HaoboChen1887/FaceTrackingDrone/poster/ground station.jpeg

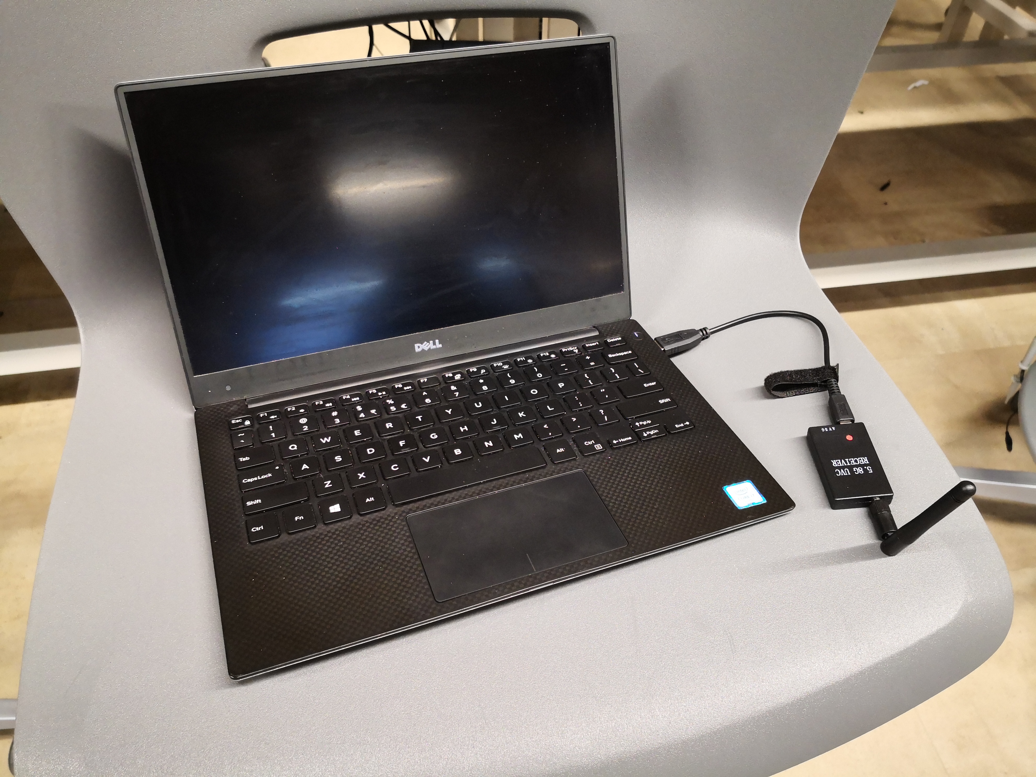
poster/ground station.jpeg
