HaoboChen1887/FaceTrackingDrone/poster/drone.jpeg

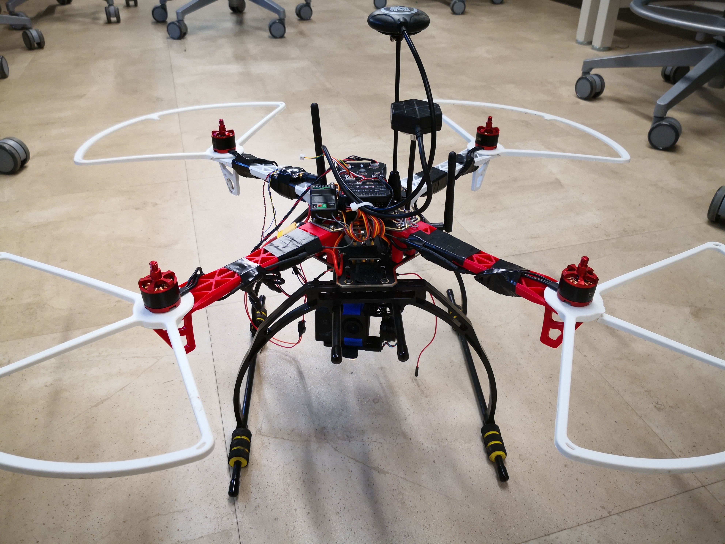
poster/drone.jpeg
