HaoboChen1887/FaceTrackingDrone/poster/requirement.png

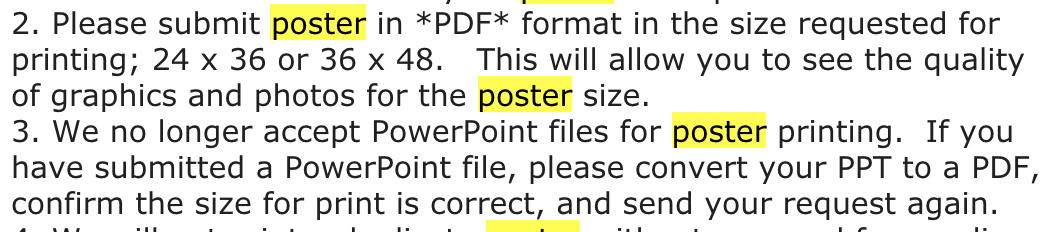
poster/requirement.png
