HaoboChen1887/FaceTrackingDrone/Untitled Diagram.png

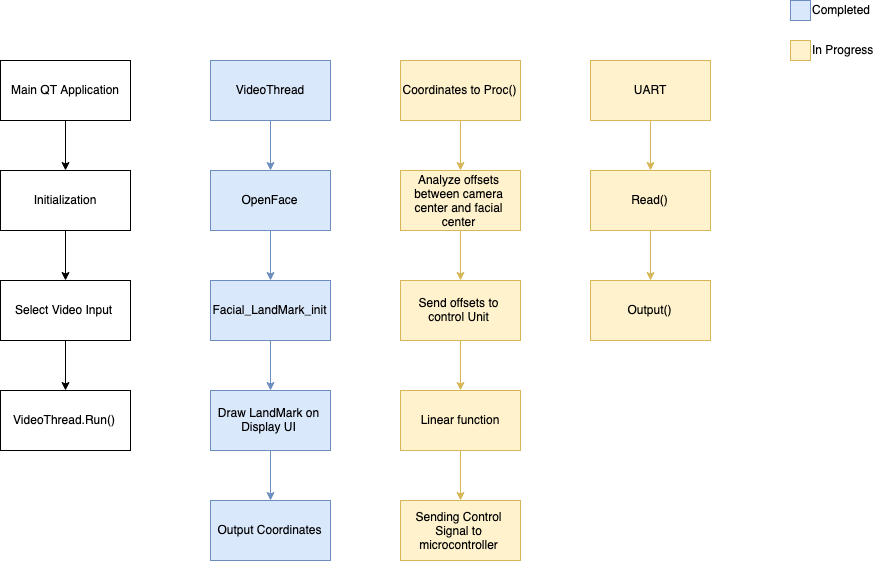
Untitled Diagram.png
