HaoboChen1887/FaceTrackingDrone/Documents(Assignments)/5_BillOfMaterials.xlsx

ECE477 Bill of Materials v1.0
Year: | 2019 |  | Semester: | Spring | Project Name: | Face Tracking Drone
Author: | Xufei Gao | gao288@purdue.edu
 | Xingchen Wang | wang2930@purdue.edu
 | Yi Qiao | qiao22@purdue.edu
 | Haobo Chen | chen1887@purdue.edu
Created: | Jan 29,2019
Last Modified: | Jan 29,2019
Project_Component |  |  |  |  |  |  |  | Qty:
Description | ID | Qty | Value | Package | Manufacturer | Mfg. Part # | Supplier | Supplier Part #
Microcontroller
FS-i6X 10CH 2.4GHz AFHDS RC Transmitter w/ FS-iA6B Receiver |  | 1 |  | standalone | Flysky | FS-i6X | Amazon | N/A
DJI Genuine Plastic 9450 Self-tightening Propellers | 9450 | 4 |  | standalone | DJI | - | Amazon | N/A
FPV 5.8GHz Receiver, 150CH UVC Video Downlink OTG Receiver |  | 1 |  | standalone | Otryad | - | Amazon | N/A
Wolfwhoop T86 0/25mW/200mW/600mW Switchable FPV Transmitter |  | 1 |  | standalone | Wolfwhoop | T86 | Amazon | N/A
Goliton 5.8g Transmitter FPV A/v Video Real-time Output Cable Cord |  | 1 |  | standalone | Goliton |  | Amazon | N/A
HRB 11.1V 5000mAh 3S 50C-100C LiPo Battery |  | 2 |  | standalone | HRB |  | Amazon | N/A
YoungRC F450 Drone Frame Kit 4-Axis Airframe 450mm Quadcopter Frame Kit with Landing Skid Gear |  | 1 |  | standalone |  | F450 | Amazon | N/A
Radiolink Pixhawk PX4 32 Bit ARM Flight Controller + NEO-M8N GPS + Pixhawk Power Module |  | 1 |  | bundle | Radiolink | PX4 | Amazon | N/A
LHI 4x 2212 920KV Brushless Motor (CW / CCW) + 4x SIMONK 30A ESC |  | 1 |  | bundle | LHI |  | Amazon | N/A
NRF24L01+PA+LNA Wireless Transceiver RF Transceiver Module 2.4G 1100m with Antenna |  | 2 |  | pin | Makerfocus | nrf24l01+ | Amazon | N/A
Capacitor (0.1uF) |  | 3 | 0.1uF | 1206 | Vishay | VJ1206V106ZXQTW1BC | Mouser | 77-VJ1206V106ZXQTBC
