HaoboChen1887/FaceTrackingDrone/Packaging/face_tracking_drone_onflight v1.step

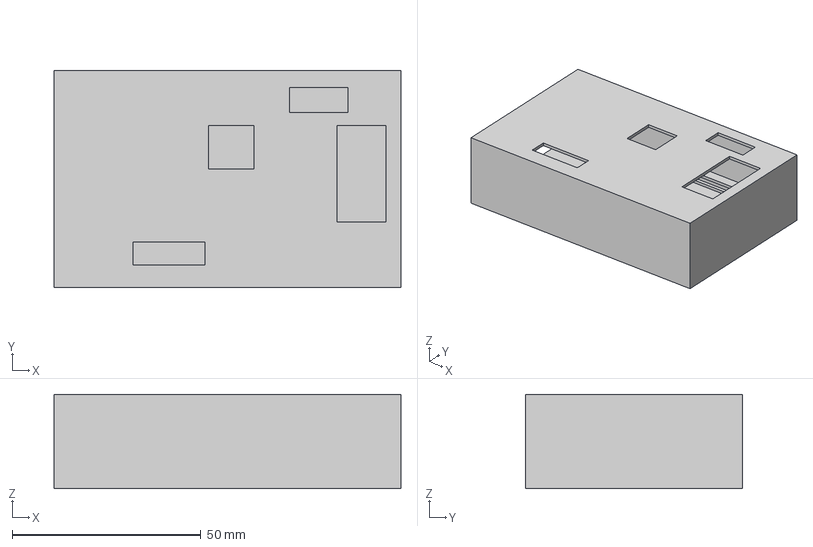
[picture p46: CAD file, 2020-08-21]
Packaging/face_tracking_drone_onflight v1.step
92.0 x 57.5 x 25.0 mm
