HaoboChen1887/FaceTrackingDrone/Packaging/face_tracking_drone_onflight.stl

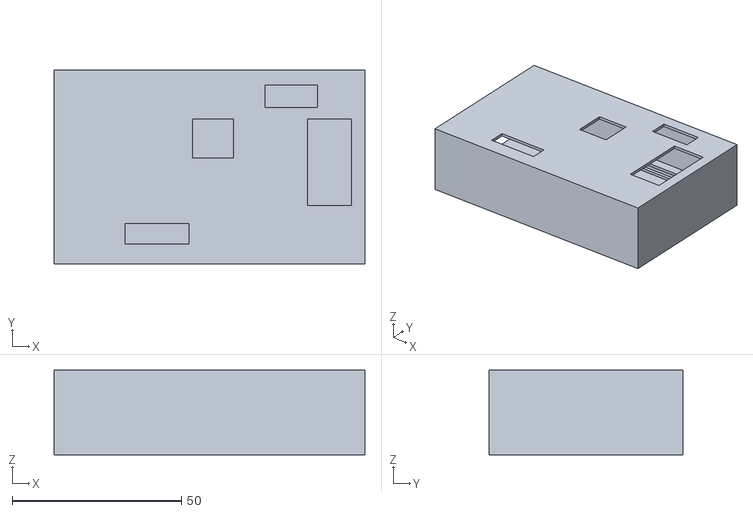
[picture p47: CAD file, 2020-08-21]
Packaging/face_tracking_drone_onflight.stl
92.0 x 57.5 x 25.0
