HaoboChen1887/FaceTrackingDrone/PCB/face_tracking_drone_ground.brd

## EAGLE design PCB/face_tracking_drone_ground.brd (2020-08-21)

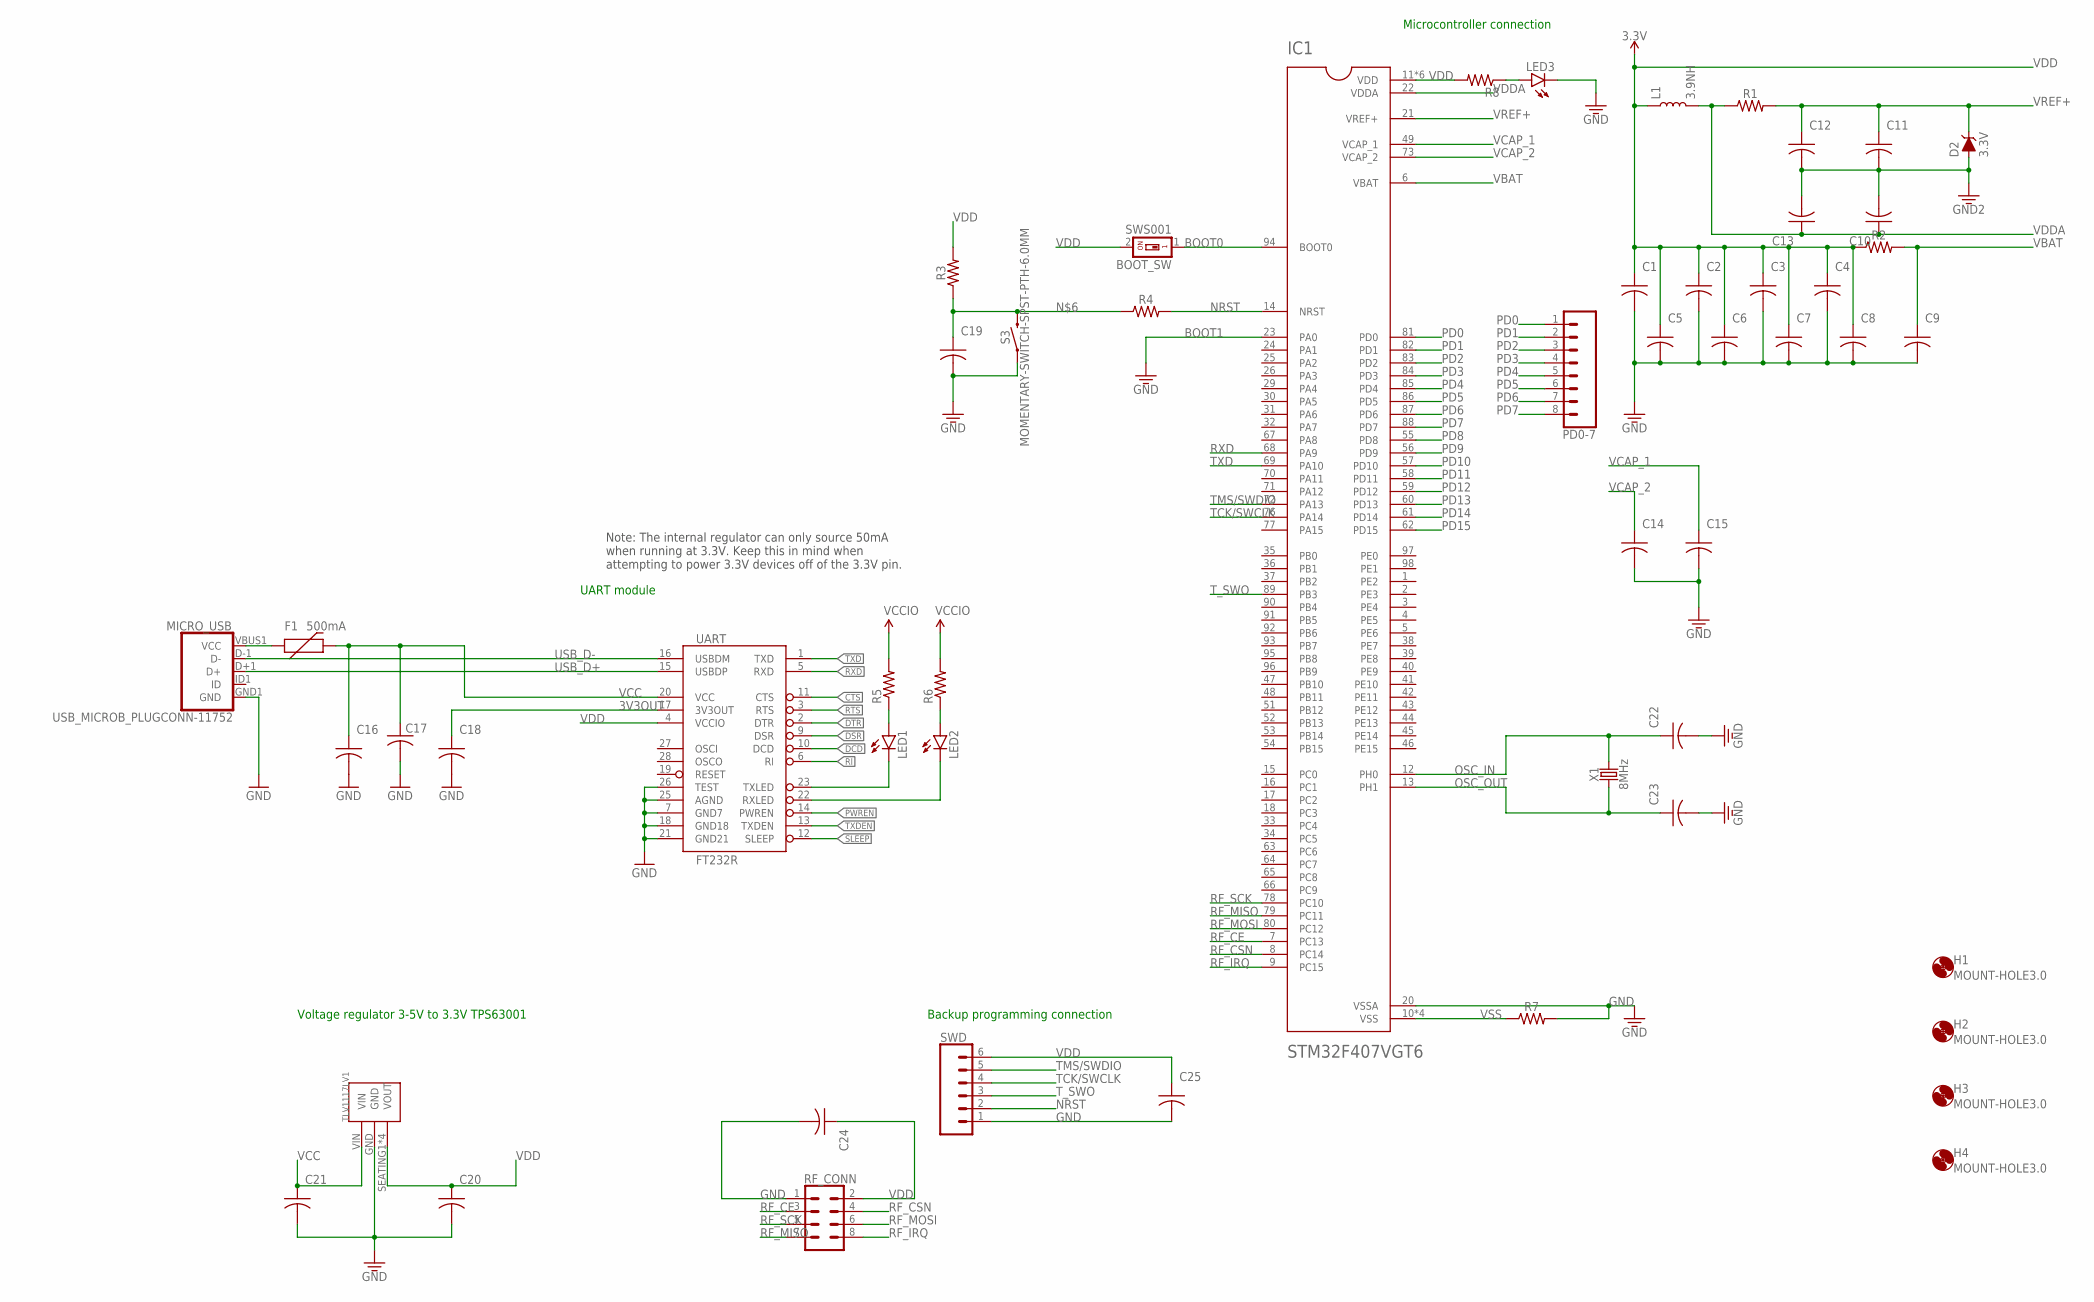
[picture p48: schematic face_tracking_drone_ground.sch]

Parts:
BOOT_SW: SWS001; SMS-001
C1, C2, C3, C4, C5, C6, C7, C8, C9, C10, C11, C16, C18, C20, C21, C24, C25: 0.1uF; C0805
C12, C13: 1uF; C0805
C14, C15, C19: 2.2uF; C0805
C17: 10uF; C0805
C22, C23: 20pF; C0805
D2: 3.3V; SOD-323
F1: 500mA; PTC-1206
H1, H2, H3, H4: MOUNT-HOLE3.0; 3,0
IC1: STM32F407VGT6; QFP50P1600X1600X160-100N
L1: 3.9NH; 0402
LED1: Red; SML0805
LED2, LED3: Green; SML0805
MICRO_USB: USB_MICROB_PLUGCONN-11752; USB-B-MICRO-SMD_V03
PD0-7: CONN_08"; 1X08
R1, R2, R3, R4, R5, R6, R8: M0805
R7: 0805
RF_CONN: CONN_04X2; 2X4
S3: MOMENTARY-SWITCH-SPST-PTH-6.0MM; TACTILE_SWITCH_PTH_6.0MM
SWD: CONN_06SILK_FEMALE_PTH; 1X06
TLV1117LV1: TLV1117LV33DCYR
UART: FT232R; SSOP28DB
X1: 8MHz; HC49U

Connections:
3V3OUT: C18.1, UART.17 (3V3OUT)
BOOT0: BOOT_SW.1, IC1.94 (BOOT0)
BOOT1: IC1.23 (PA0)
CTS: UART.11 (CTS)
DCD: UART.10 (DCD)
DSR: UART.9 (DSR)
DTR: UART.2 (DTR)
GND: C1.2, C2.2, C3.2, C4.2, C5.2, C6.2, C7.2, C8.2, C9.2, C10.2, C11.2, C12.2, C13.2, C14.2, C15.2, C16.2, C17.2, C18.2, C19.2, C20.2, C21.2, C22.2, C23.2, C24.2, C25.2, D2.A, IC1.20 (VSSA), LED3.C, MICRO_USB.GND1 (GND), R7.2, RF_CONN.1, S3.1, SWD.1, TLV1117LV1.GND, UART.7 (GND7), UART.18 (GND18), UART.21 (GND21), UART.25 (AGND), UART.26 (TEST)
unnamed: LED1.A, R5.1
unnamed: LED3.A, R8.1
unnamed: LED2.A, R6.1
unnamed: F1.1, MICRO_USB.VBUS1 (VCC)
unnamed: C19.1, R3.1, R4.1, S3.3 (2)
NRST: IC1.14 (NRST), R4.2, SWD.2
OSC_IN: C22.1, IC1.12 (PH0), X1.2
OSC_OUT: C23.1, IC1.13 (PH1), X1.1
PD0: IC1.81 (PD0), PD0-7.1
PD1: IC1.82 (PD1), PD0-7.2
PD2: IC1.83 (PD2), PD0-7.3
PD3: IC1.84 (PD3), PD0-7.4
PD4: IC1.85 (PD4), PD0-7.5
PD5: IC1.86 (PD5), PD0-7.6
PD6: IC1.87 (PD6), PD0-7.7
PD7: IC1.88 (PD7), PD0-7.8
PD8: IC1.55 (PD8)
PD9: IC1.56 (PD9)
PD10: IC1.57 (PD10)
PD11: IC1.58 (PD11)
PD12: IC1.59 (PD12)
PD13: IC1.60 (PD13)
PD14: IC1.61 (PD14)
PD15: IC1.62 (PD15)
PWREN: UART.14 (PWREN)
RF_CE: IC1.7 (PC13), RF_CONN.3
RF_CSN: IC1.8 (PC14), RF_CONN.4
RF_IRQ: IC1.9 (PC15), RF_CONN.8
RF_MISO: IC1.79 (PC11), RF_CONN.7
RF_MOSI: IC1.80 (PC12), RF_CONN.6
RF_SCK: IC1.78 (PC10), RF_CONN.5
RI: UART.6 (RI)
RTS: UART.3 (RTS)
RXD: IC1.68 (PA9), UART.5 (RXD)
RXLED: LED2.C, UART.22 (RXLED)
SLEEP: UART.12 (SLEEP)
TCK/SWCLK: IC1.76 (PA14), SWD.4
TMS/SWDIO: IC1.72 (PA13), SWD.5
TXD: IC1.69 (PA10), UART.1 (TXD)
TXDEN: UART.13 (TXDEN)
TXLED: LED1.C, UART.23 (TXLED)
T_SWO: IC1.89 (PB3), SWD.3
USB_D+: MICRO_USB.D+1 (D+), UART.15 (USBDP)
USB_D-: MICRO_USB.D-1 (D-), UART.16 (USBDM)
VBAT: C9.1, IC1.6 (VBAT), R2.2
VCAP_1: C15.1, IC1.49 (VCAP_1)
VCAP_2: C14.1, IC1.73 (VCAP_2)
VCC: C16.1, C17.1, C21.1, F1.2, TLV1117LV1.VIN, UART.20 (VCC)
VCCIO: R5.2, R6.2
VDD: BOOT_SW.2, C1.1, C2.1, C3.1, C4.1, C5.1, C6.1, C7.1, C8.1, C20.1, C24.1, C25.1, IC1.11 (VDD), IC1.19 (VDD), IC1.28 (VDD), IC1.50 (VDD), IC1.75 (VDD), IC1.100 (VDD), L1.1, R2.1, R3.2, R8.2, RF_CONN.2, SWD.6, TLV1117LV1.SEATING1 (VOUT), TLV1117LV1.SEATING2 (VOUT), TLV1117LV1.SEATING3 (VOUT), TLV1117LV1.VOUT, UART.4 (VCCIO)
VDDA: C10.1, C13.1, IC1.22 (VDDA), L1.2, R1.1
VREF+: C11.1, C12.1, D2.C, IC1.21 (VREF+), R1.2
VSS: IC1.10 (VSS), IC1.27 (VSS), IC1.74 (VSS), IC1.99 (VSS), R7.1

Notes on the sheet:
Microcontroller connection
Voltage regulator 3-5V to 3.3V TPS63001
Note: The internal regulator can only source 50mA when running at 3.3V. Keep this in mind when attempting to power 3.3V devices off of the 3.3V pin.
UART module
Backup programming connection

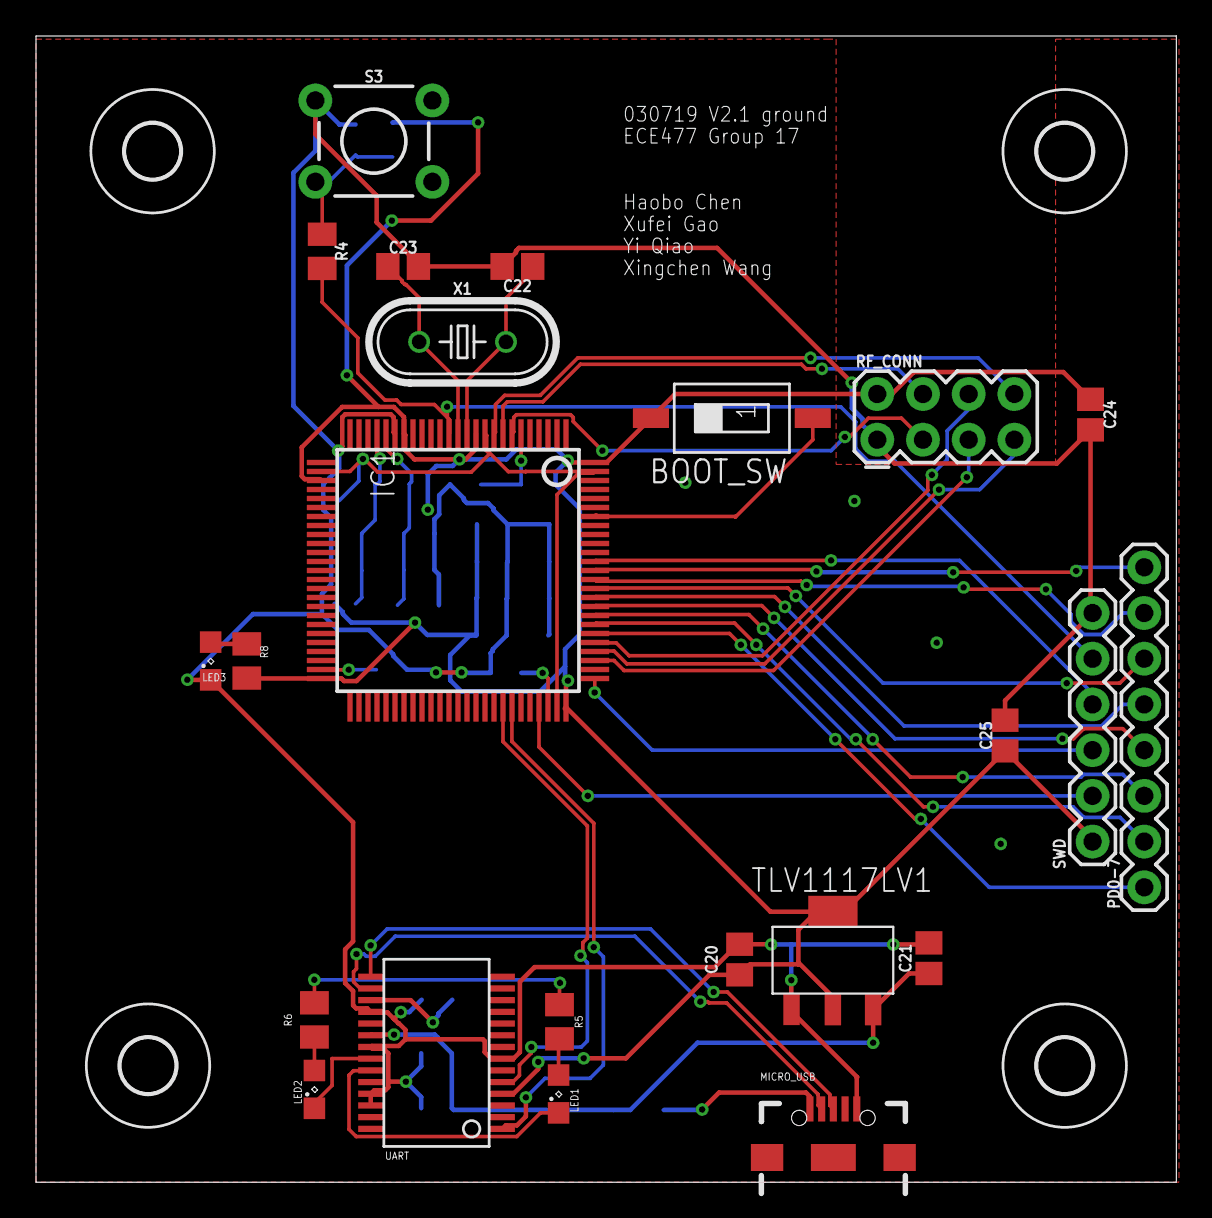
[picture p49: board face_tracking_drone_ground.brd from above]

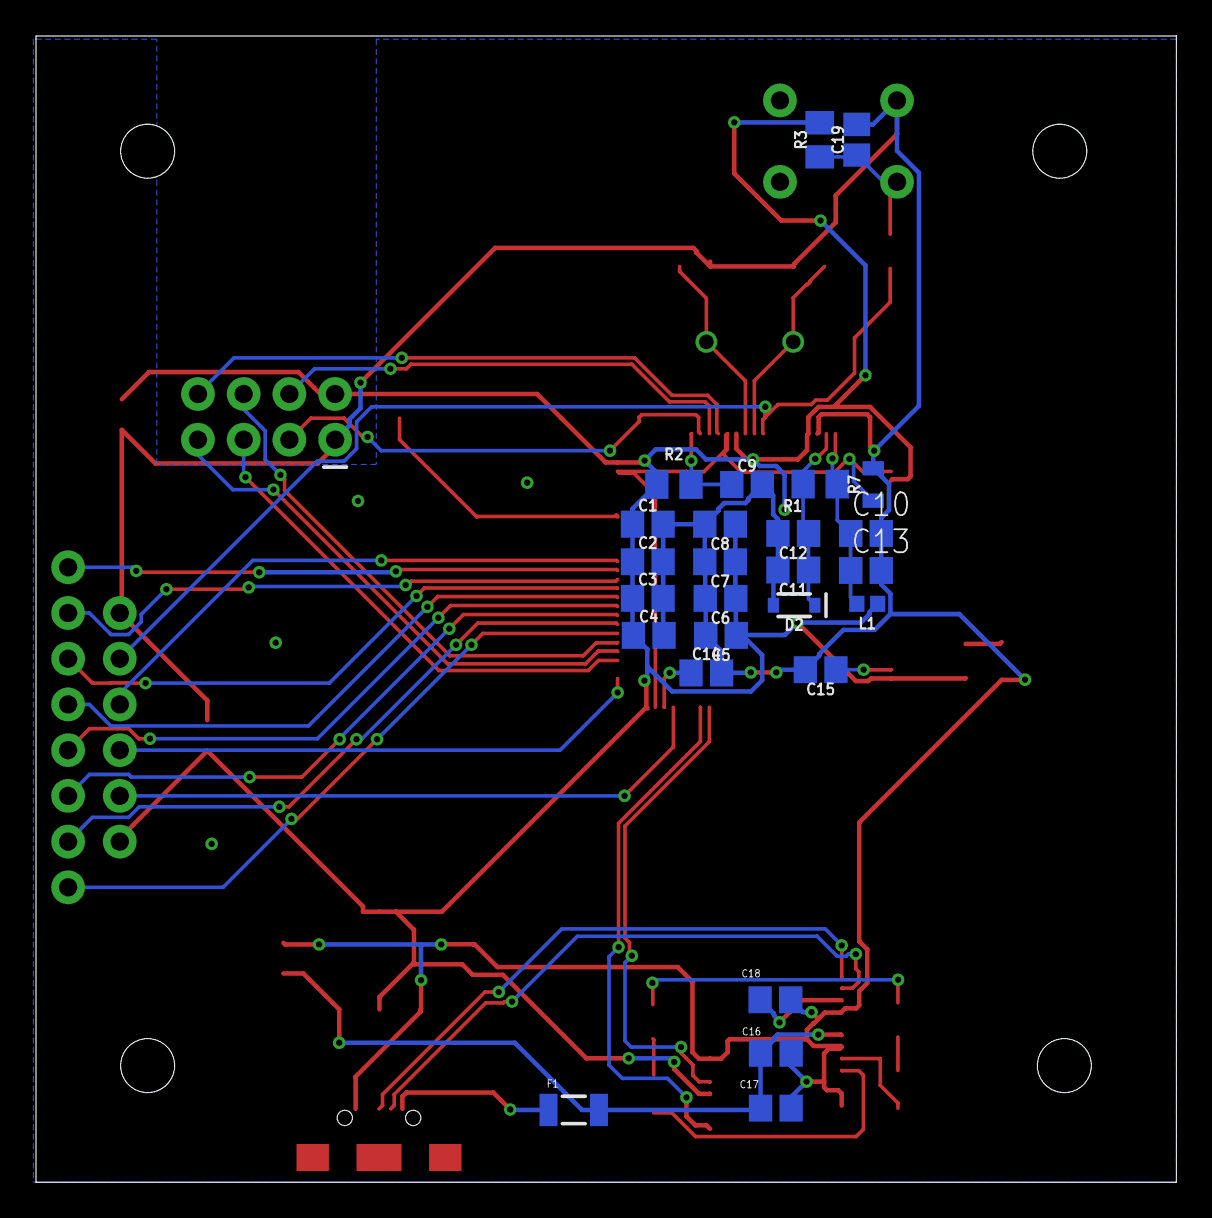
[picture p50: board face_tracking_drone_ground.brd from below]

Board: 2 copper layers, 63.4 x 63.7 mm, 53 parts (26 on the bottom side), 43 nets.
